OHNope/SelfieCamera/(commit log)

2026-09-15 sch: confirm requirements
    [rocket_nose_selfie_camera.kicad_sch]
2026-09-15 sch: resolve symbols and footprints
2026-09-15 sch: add schematic symbols and topology
    [rocket_nose_selfie_camera.kicad_sch]
2026-09-15 sch: validate power flags
    [rocket_nose_selfie_camera.kicad_sch]
2026-09-15 sch: complete schematic presentation
    [rocket_nose_selfie_camera.kicad_sch]
2026-09-15 sch: verify ERC and round-trip
    [rocket_nose_selfie_camera.kicad_sch]
2026-09-17 chore: isolate Seed XIAO camera prototype
    [rocket_nose_selfie_camera copy.kicad_sch, rocket_nose_selfie_camera.kicad_sch]
2026-09-17 chore: use official Seeed Studio project name
    [rocket_nose_selfie_camera copy.kicad_sch, rocket_nose_selfie_camera.kicad_sch]
2026-09-30 sch: logger CAN via MCP2562, separate 5V power input
    - Single CAN connector J3 (CANH/CANL/GND) to the logger board; R5 120R fitted as bus endpoint
    - J4 becomes a 2-pin +5V/GND input from the power board; D3 B5819W into XIAO VBUS
    - Replace SN65HVD230 with MCP2562-E/SN: VDD from 5V_IN (before D3), VIO 3.3V with C2, STBY to GND
    - Sync README and BOM with the schematic
    [rocket_nose_selfie_camera.kicad_sch]
2026-10-01 chore: adopt KiBot release workflow and publish public sources
    Apply the kicad-project template (KiBot 1.9 / KiCad 10 config and the
    tag-triggered release workflow), pointed at the project in
    seeed-xiao-studio-nose-camera/. Publish the public datasheet and
    reference page as real files in sources/, and keep kicad-auto's
    machine-local state and KiCad per-user settings out of Git.
2026-10-01 chore: move KiCad project to repository root
    The repository now holds only this project, so the project
    subdirectory is no longer needed. File contents are unchanged
    (pure renames); the release workflow PROJECT path is updated.
    [rocket_nose_selfie_camera.kicad_sch]
2026-10-01 ci: call the shared kicad-release pipeline
    The release logic and default KiBot config now live in OHNope/kicad-release,
    which derives the schematic/board names from the root .kicad_pro, so the
    local copy and its PROJECT override are no longer needed.
